LZ1DPN/Forty-9er/PDP/Forty-9er/oled.jpg

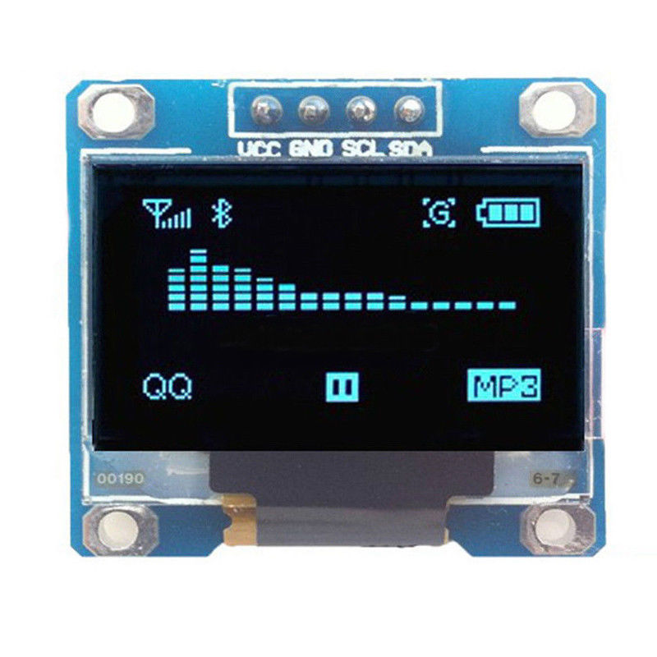
PDP/Forty-9er/oled.jpg
