LZ1DPN/Forty-9er/PDP/Forty-9er/2nd-49er-modification.png

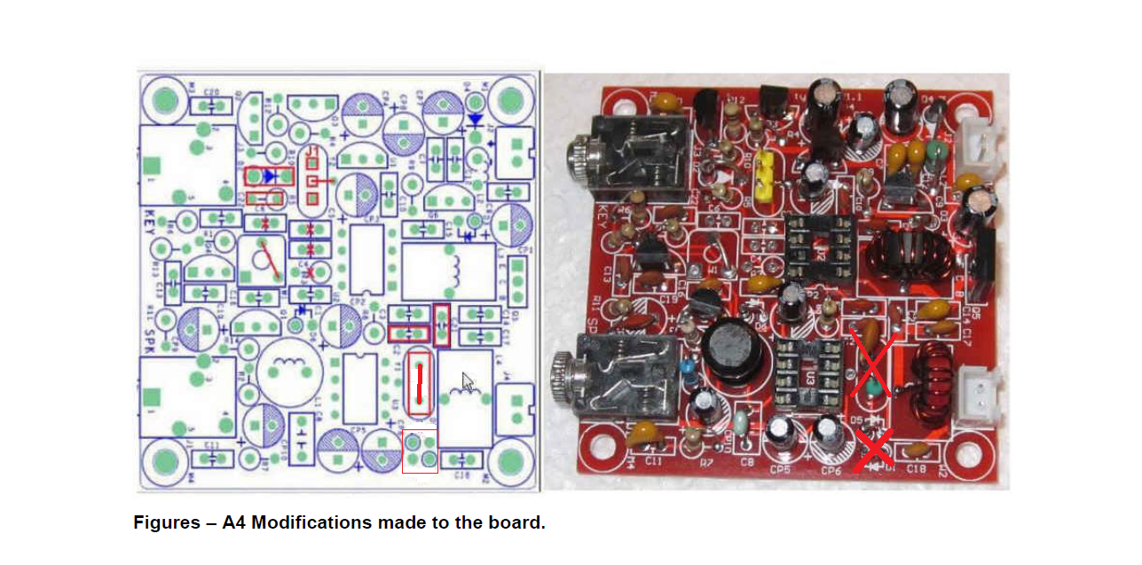
PDP/Forty-9er/2nd-49er-modification.png
