LZ1DPN/Forty-9er/PDP/Forty-9er/AD9833-VFO-schema.jpg

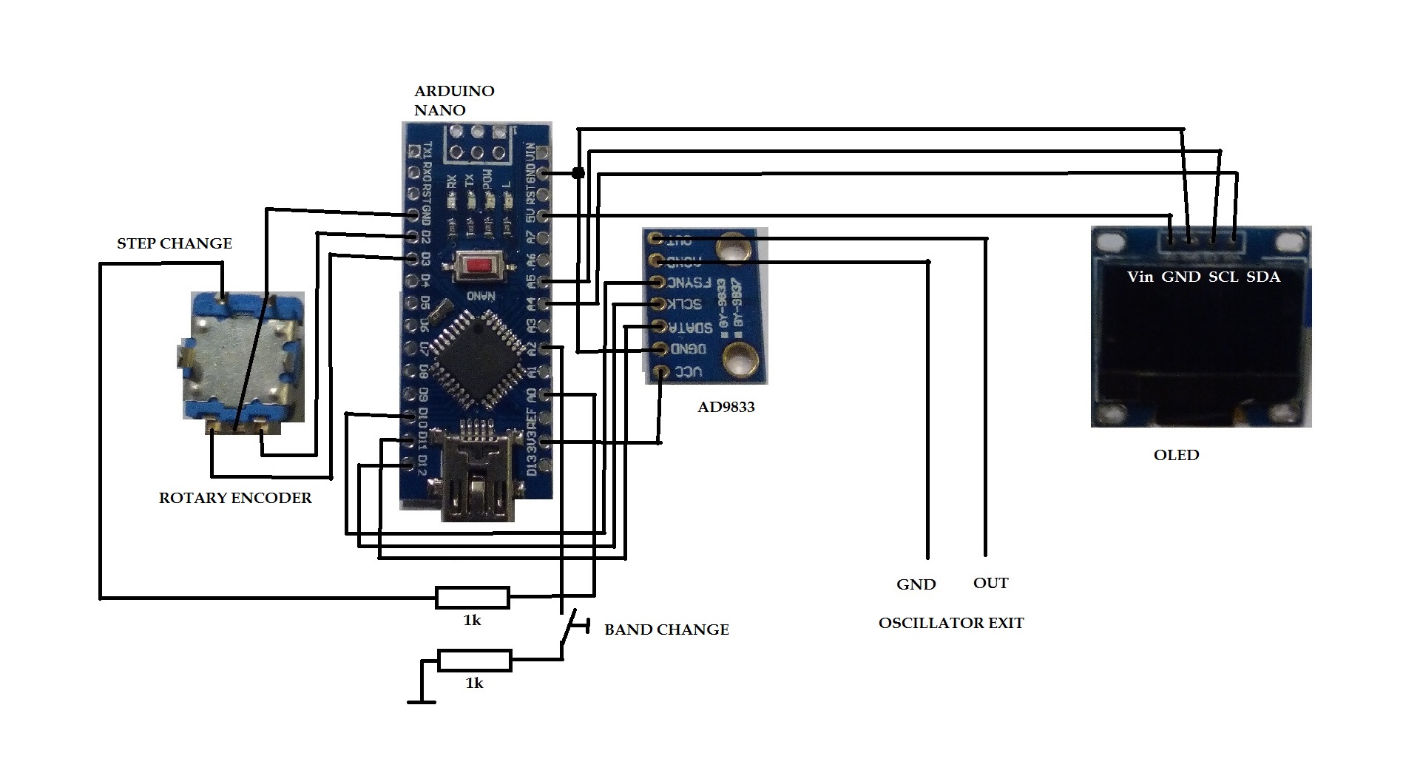
PDP/Forty-9er/AD9833-VFO-schema.jpg
