LZ1DPN/Forty-9er/PDP/Forty-9er/RFamplifier.png

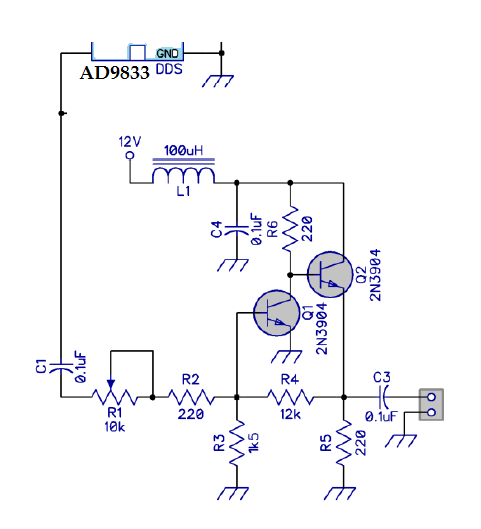
PDP/Forty-9er/RFamplifier.png
