LZ1DPN/Forty-9er/PDP/Forty-9er/Forty-9erVFO/Forty-9erVFO.ino

/*
Forty-9er VFO and controler - HAM radio transceiver for HF bands
Revision 1.0 - June 22, 2019

Support for AD9833 oscillator (VFO for Forty-9er)
Band is set up for 40m only (7 MHz), band change is stopped in software. 
RIT doesn't have meaning in DC transceiver,
Uncomment all functionality you need.
*/

// Include the library code for external hardware
#include <SPI.h>
#include <rotary.h>

//define OLED pinout and reset
#include <Adafruit_SSD1306.h>
#define OLED_RESET 5   //12
Adafruit_SSD1306 display(OLED_RESET);

// arduino pinout define
#define FBUTTON (A0)       // tuning step freq CHANGE from 1Hz to 1MHz step for single rotary encoder possition
#define BTNDEC (A2)        // BAND CHANGE BUTTON from 1,8 to 29 MHz - 11 bands

//AD9833 arduino comunication pinouts control
const int FSYNC = 10;                       // Standard SPI pins for the AD9833 waveform generator.
const int CLK = 13;                         // CLK and DATA pins are shared with the TFT display.
const int DATA = 11;
const float refFreq = 25000000.0;           // On-board crystal reference frequency

//AD9833 variables
const int SINE = 0x2000;                    // Define AD9833's waveform register value.
const int SQUARE = 0x2028;                  // When we update the frequency, we need to
const int TRIANGLE = 0x2002;                // define the waveform when we end writing.    
int wave = 0;
int waveType = SQUARE;
int wavePin = 7;

// define pinout/in 
#define pulseHigh(pin) {digitalWrite(pin, HIGH); digitalWrite(pin, LOW); }

//rotary encoder pins define
Rotary r = Rotary(3,2); // sets the pins for rotary encoder uses.  Must be interrupt pins.

//FREQ var  
unsigned long rx=7000000; // VFO starting frequency
unsigned long rx2=1; // temp variable to hold the updated frequency
unsigned long rxof=0; //800 receiver ofset
unsigned long increment = 50; // starting VFO update increment in HZ. tuning step
String hertz = "50Hz";
int  hertzPosition = 0;
String freq; // string to hold the frequency

// buttons temp var
int buttonstate = 0;   // temp var
int BTNdecodeON = 0;
int BTNinc = 4; // set number of default band minus 1

// RIT var
int rxRIT=0;
int RITon=0;

// start variable setup

void setup() {

//set up the pins in/out and logic levels

pinMode(BTNDEC,INPUT);    // band change button
digitalWrite(BTNDEC,HIGH);    // level

pinMode(FBUTTON,INPUT); // Connect to a button that goes to GND on push - rotary encoder push button - for FREQ STEP change
digitalWrite(FBUTTON,HIGH);  //level

// Initialize the Serial port so that we can use it for debugging
Serial.begin(115200);
  
// Can't set SPI MODE here because the display and the AD9833 use different MODES.
SPI.begin();
delay(50); 

  AD9833reset();                                   // Reset AD9833 module after power-up.
  delay(50);
  AD9833setFrequency((rx+rxRIT-rxof), SQUARE);                  // Set the frequency and Square Wave output

  // by default, we'll generate the high voltage from the 3.3v line internally! (neat!)
  // OLED init 
  display.begin(SSD1306_SWITCHCAPVCC, 0x3C);  // initialize with the I2C address 0x3C (for oled 128x32)
  
  // Show image buffer on the display hardware.
  // Since the buffer is intialized with an Adafruit splashscreen
  // internally, this will display the splashscreen.
  display.display();

  // Clear the OLED buffer.
  display.clearDisplay();	
  display.setTextSize(2);
  display.setTextColor(WHITE);
  display.setCursor(0,0);
  display.println(rx);
  display.setTextSize(1);
  display.setCursor(0,16);
  display.print("St:");display.print(hertz);
  display.setCursor(64,16);
  display.print("rit:");display.print(rxRIT);
  display.display();
  
   // rotary encoder init
  PCICR |= (1 << PCIE2);
  PCMSK2 |= (1 << PCINT18) | (1 << PCINT19);
  sei();
  
  // first init and send frequency to AD9833
    AD9833setFrequency((rx+rxRIT-rxof), SQUARE);     // Set AD9833 to frequency and selected wave type.
    delay(50);
}

///// START MAIN LOOP
void loop() {

//	checkBTNdecode();  // BAND change - now stopped
	
// freq change 
  if ((rx != rx2) || (RITon == 1)){
	  showFreq();
      AD9833setFrequency((rx+rxRIT-rxof), SQUARE);     // Set AD9833 to frequency and selected wave type.
      rx2 = rx;
      }

//  step freq change + RIT ON/OFF  
  buttonstate = digitalRead(FBUTTON);
  if(buttonstate == LOW) {
        setincrement();        
    };

}	  
/// END of main loop ///
/// ===================================================== END ============================================


/// START EXTERNAL FUNCTIONS

// rotary encoder read
ISR(PCINT2_vect) {
  unsigned char result = r.process();
if (result) {  
	if (RITon==0){
		if (result == DIR_CW){rx=rx+increment;}
		else {rx=rx-increment;}
	}
	if (RITon==1){
		if (result == DIR_CW){
		  rxRIT=rxRIT+50;
		  }
		else {
		  rxRIT=rxRIT-50;
	 	  }
  } 
}
}

// step increment for rotary encoder button
void setincrement(){
  if(increment == 0){increment = 1; hertz = "1Hz"; hertzPosition=0;RITon=0;} 
  else if(increment == 1){increment = 10; hertz = "10Hz"; hertzPosition=0;RITon=0;}
  else if(increment == 10){increment = 50; hertz = "50Hz"; hertzPosition=0;RITon=0;}
  else if (increment == 50){increment = 100;  hertz = "100Hz"; hertzPosition=0;RITon=0;}
  else if (increment == 100){increment = 500; hertz="500Hz"; hertzPosition=0;RITon=0;}
  else if (increment == 500){increment = 1000000; hertz="1Mhz"; hertzPosition=0;RITon=0;} 
  else{increment = 0; hertz = "ritON"; hertzPosition=0; RITon=1;};  
  showFreq();
  delay(250); // Adjust this delay to speed up/slow down the button menu scroll speed.
}

// oled display function
void showFreq(){
	display.clearDisplay();	
	display.setTextSize(2);
	display.setTextColor(WHITE);
	display.setCursor(0,0);
	display.println(rx);
	Serial.println(rx);
	display.setTextSize(1);
	display.setCursor(0,16);
	display.print("St:");display.print(hertz);
	display.setCursor(64,16);
	display.print("rit:");display.print(rxRIT);
	display.display();
}

// AD9833 documentation advises a 'Reset' on first applying power.
void AD9833reset() {
  WriteRegister(0x100);   // Write '1' to AD9833 Control register bit D8.
  delay(10);
}

// Set the frequency and waveform registers in the AD9833.
void AD9833setFrequency(long frequency, int Waveform) {

  long FreqWord = (frequency * pow(2, 28)) / refFreq;

  int MSB = (int)((FreqWord & 0xFFFC000) >> 14);    //Only lower 14 bits are used for data
  int LSB = (int)(FreqWord & 0x3FFF);
  
  //Set control bits 15 ande 14 to 0 and 1, respectively, for frequency register 0
  LSB |= 0x4000;
  MSB |= 0x4000; 
  
  WriteRegister(0x2100);   
  WriteRegister(LSB);                  // Write lower 16 bits to AD9833 registers
  WriteRegister(MSB);                  // Write upper 16 bits to AD9833 registers.
  WriteRegister(0xC000);               // Phase register
  WriteRegister(Waveform);             // Exit & Reset to SINE, SQUARE or TRIANGLE
}

void WriteRegister(int dat) { 
  
  // Display and AD9833 use different SPI MODES so it has to be set for the AD9833 here.
  SPI.setDataMode(SPI_MODE2);       
  digitalWrite(FSYNC, LOW);           // Set FSYNC low before writing to AD9833 registers
  delayMicroseconds(10);              // Give AD9833 time to get ready to receive data.
  SPI.transfer(highByte(dat));        // Each AD9833 register is 32 bits wide and each 16
  SPI.transfer(lowByte(dat));         // bits has to be transferred as 2 x 8-bit bytes.
  digitalWrite(FSYNC, HIGH);          //Write done. Set FSYNC high
}


//  BAND CHANGE !!! band plan - change if need - now stopped 
void checkBTNdecode(){
  
BTNdecodeON = digitalRead(BTNDEC);    
    if(BTNdecodeON == LOW){
         BTNinc = BTNinc + 1;
         
         if(BTNinc > 6){
              BTNinc = 2;
              }
              
          switch (BTNinc) {
          case 1:
            rx=1810000;
            break;
          case 2:
            rx=3500000;
            break;
          case 3:
            rx=5351500;
            break;
          case 4:
            rx=7000000;
            break;
          case 5:
            rx=10100000;
            break;
          case 6:
            rx=14000000;
            break;
          case 7:
            rx=18068000;
            break;    
          case 8:
            rx=21000000;
            break;    
          case 9:
            rx=24890000;
            break;    
          case 10:
            rx=28000000;
            break;
          case 11:
            rx=29100000;
            break;        
          default:             
            break;
        }         
        delay(250);     
    }
}

// END OF FILE
